uf-focus-lab/DuoController/board/specs.md

# FoveaCam Duo Driver (FoveaCamDuo-PCB): board specification, V0.1

State 2026-10-07, v0.1.2 (frozen 2026-10-07, tag v0.1.2). Generated by `board/layout.py` from `netlist.py`, `placement.py`,
`routes.py`, `silk_front.py`, `silk_back.py` and `lib/rules.py`. V0.0 is the
hand-drawn board of git 289fb6c. Requirements and the dated decision log are in the
root `specs.md`; this file holds the board's numbers. Unknowns are marked TODO.

## 1. Purpose

A Teensy 4.0 carrier that drives two Mirrorcle MEMS drivers (digital input,
AD5664R), one independent SPI bus each, triggers and reads three FLIR Blackfly S
cameras (four lines each), offers two UARTs and three 5 V fan outputs. No active
parts besides the Teensy; four optional capacitor footprints.

## 2. Block diagram

```
           J_UART1 (PH5)       J_PWR3 (PH2 fan)       J_UART2 (PH5)
           5 3 G RX1 TX1         +5V GND               5 3 G RX2 TX2
                 \                   |                    /
 J_PWR1 (PH2 fan)  J_SPI1 (DRV1) == bus 1 ==  U1 Teensy 4.0 (back) == bus 2 == J_SPI2 (DRV2)  J_PWR2 (PH2 fan)
                     EN, FCLK shared by both ports
                 /                   |                    \
           J_CAM1 (PH6)        J_CAM0 (PH6)          J_CAM2 (PH6)
           L3 IN L2 OUT GND    L3 IN L2 OUT GND      L3 IN L2 OUT GND
```

Power: +5V is the Teensy's VIN (USB VBUS through the Teensy's VIN-VUSB trace);
+3V3 is its 3V3 pin. The 2-pin sockets are fan OUTPUTS (section 5).

## 3. Teensy 4.0 pin map and the SPI buses (`board/pins.h` is generated from this)

Owner 2026-10-07: "You have permission to reorder pins if it helps with routing".
Old (V0.0) -> new (V0.1), with the reason for every move:

| Pin | V0.0 | V0.1 | Reason |
|---|---|---|---|
| 0 / 1 | RX1 / TX1 | RX1 / TX1 | Serial1 (fixed pair), straight to J_UART1 |
| 2 | GPIO header | CS1 | west-most DRV1 lane = J_SPI1 pin 7 order |
| 3 | GPIO header | SCLK1 | FlexIO1 D05; SCLK1 / MOSI1 one FlexIO module |
| 4 | GPIO header | MOSI1 | FlexIO1 D06 |
| 5 | GPIO header | CAM2_L3 | the 12th camera line; south row has 11 GPIOs; runs south of the bus lanes, round the Teensy's east end |
| 6 | GPIO header | MEMS_EN | GPIO_B0_10: 100 k pull-down during reset, keeper after it (i.MX RT1060 data sheet Rev. 4, Table 83, PDF p95; boot pins p85), so EN stays low until firmware drives it; west-most DRV2 lane |
| 7 / 8 | RX2 / TX2 | RX2 / TX2 | Serial2 (fixed pair) |
| 9 | CS1 | CS2 | DRV2 lane order (pin 7 of J_SPI2) |
| 10 | CS2 | FCLK | PWM pin; shared; its DRV1 branch runs along the north band and down the pin-row gap between pins 2 and 3 |
| 11 | MOSI (shared) | MOSI2 | FlexIO2 D02; straight up into the north wrap |
| 12 | NC (MISO) | SCLK2 | FlexIO2 D01; inner north wrap |
| 13 | SCLK (shared) | CAM2_IN | camera order on the south row (13 also drives the LED: it lights with the camera 2 trigger) |
| 14 | FCLK | CAM2_L2 | camera order |
| 15 | MEMS_EN | CAM2_OUT | camera order (strobe input) |
| 16 | NC | CAM0_L3 | camera order |
| 17 | NC | CAM0_IN | camera order |
| 18 | CAM2_IN | CAM0_L2 | camera order |
| 19 | CAM2_OUT | CAM0_OUT | camera order |
| 20 | CAM0_IN | CAM1_L3 | camera order |
| 21 | CAM0_OUT | CAM1_IN | camera order |
| 22 | CAM1_IN | CAM1_L2 | camera order |
| 23 | CAM1_OUT | CAM1_OUT | camera order |
| 24, 25 + G, 26 | 3V3, GND, VIN | same | rails |

Peripheral sources: Teensyduino 1.159 `FlexIO_t4.cpp` (Teensy 4.0 section:
flex1_hardware pins 2, 3, 4, 5 = FlexIO1 D04, D05, D06, D08; flex2_hardware pins 6-13
= FlexIO2 D10, D17, D16, D11, D00, D02, D01, D03), `core_pins.h` (pin 6 =
GPIO_B0_10, pin 2 = GPIO_EMC_04). LPSPI4 (11/12/13) is not used: pin 13 is on the
other row. Every edge GPIO is used, so MEMS_EN stays shared; an enable per driver is
wanted when a later revision frees a GPIO (owner 2026-10-07).

Routing (all checked on every build):

- Each bus's CS / SCLK / MOSI run on F.Cu only, over the unbroken B.Cu ground plane,
  with no crossing and no plane slot under them. DRV1: lanes under the Teensy
  (CS1 -2.54, FCLK 0, SCLK1 2.54, MOSI1 4.6 mm), funnel to J_SPI1, SCLK1 / MOSI1 wrap
  round its south end. DRV2: SCLK2 / MOSI2 straight up from pins 12 / 11 into the
  north band and round the north end of J_SPI2; FCLK / CS2 / MEMS_EN in lanes under
  the Teensy and up risers.
- Shared lines: the J_SPI pin order (FCLK between SYN and SCK, EN north of SYN on
  J_SPI1 but south of it on J_SPI2, the port rotated 180 degrees) forces MEMS_EN to
  cross FCLK once; MEMS_EN (static) takes that crossing on B.Cu. FCLK's north band
  passes over three short B.Cu jumps (MEMS_EN, RX2, TX2), flanked by stitching vias.
  MEMS_EN reaches J_SPI1 from the north and jumps under RX1 / TX1 on B.Cu.
- Lengths: CS1 24.2, SCLK1 38.7, MOSI1 48.4, CS2 38.3, SCLK2 18.6, MOSI2 26.6 mm;
  FCLK tree 86.6, MEMS_EN tree 85.3 mm.
- Spacing: SCLK1 / MOSI1 run 14.1 mm side by side at >= 1.1 mm (edge gap 0.85 mm,
  3.3 W); SCLK2 / MOSI2 14.6 mm at 1.05 mm (3.1 W; V0.1 draft: 12.3 mm at 0.8 mm,
  cross-check 2026-10-07). FCLK beside SCLK1 11.4 mm at 1.27 mm (the descent between
  Teensy pins 2 and 3), beside SCLK2 5.4 mm at 1.15 mm, with GND pour between.
- Track width 0.254 mm on 1.51 mm FR-4 over the B plane: microstrip about 130 ohm
  without the pour, about 100 ohm with the coplanar GND pour 0.2 mm away (estimates;
  no stackup in the board file); delay about 5.8 ps/mm (eps_eff about 3.0).
- Crosstalk on the board, worst case FCLK -> SCLK1 (11.4 mm at 1.27 mm): backward
  coefficient about 0.15 x (2 x 11.4 mm x 5.8 ps/mm) / t_r, so about 1 % of 3.3 V
  (30 mV) at a 2 ns edge: far below the 0.4 V input low limit (Mirrorcle p14). The
  ribbon cable dominates: in the 2x5 IDC cable SCK (pin 8) lies next to SYN (7) and
  FCLK_X (9) for 152 mm with one ground (pin 4); Mirrorcle p10 warns of crosstalk from
  fast FCLK / SPI edges and asks for reduced slew rates.

Timing (SCLK at f, 24-bit frame; board + cable delay about 0.2 ns + 0.8 ns one way):

| SCLK | half period | board SCLK/MOSI skew | frame (24 bits) | 4 channels |
|---|---|---|---|---|
| 1 MHz | 500 ns | < 0.06 ns | 24 us | 96 us |
| 5 MHz | 100 ns | < 0.06 ns | 4.8 us | 19.2 us |
| 10 MHz (recommended maximum until measured) | 50 ns | < 0.06 ns | 2.4 us | 9.6 us |
| 20 MHz | 25 ns | < 0.06 ns | 1.2 us | 4.8 us |

The AD5664R limits (maximum SCLK, SYNC and data set-up / hold) are TODO: the ADI
data sheet could not be fetched (site blocked from this machine). Mirrorcle: data
taken on the falling SCLK edge (p26), 24-bit words (p42).

Freeze analysis ("it randomly enters undeterministic state and froze itself"):

- Board (V0.0): one SCLK / MOSI branched to two connectors and two 6 inch cables
  with no termination and the Teensy's strongest drive: reflections from the open
  branch can double-clock the AD5664R; a corrupted 24-bit word can set a channel to
  power-down, switch the reference off or load a wrong code, and the DAC stays there
  until re-initialised. V0.1: one point-to-point bus per DAC, unbroken plane, GND pin
  of each port tied to the plane, stitching along every lane.
- Board / power: the drivers need VDD 4.85-5.2 V (p14) and have supply monitoring
  with auto-shutdown (p3); USB allows 4.75 V at the port, less after the cable and
  the Teensy. A dip (driver start-up pulses of 100 mA, fans) can shut a driver down,
  which looks like a freeze. Measure VDD at J_SPI pin 3 under load (open item).
- Firmware: no FCLK means fixed outputs (p50); CS asserted before the SPI settings
  and broadcast writes on the shared bus (V0.0 code); EN raised before the DAC init
  and FCLK (p27 order); the DAC not re-initialised per power-up (p26). Fixes in
  `board/pins.h` firmware notes and section 6.

## 4. Connectors

| Ref | Part | Side | Mating face | Pin 1 |
|---|---|---|---|---|
| J_SPI1 / J_SPI2 | CNC Tech 3220-10-0200-00, 2x5 1.27 mm right angle | W / E | 1.00 mm beyond the outline (FACE_BOX 5.90, drawing 2020) | Mirrorcle p10 order |
| J_PWR1 / J_PWR2 | JST S2B-PH-K, side entry | W / E | 1.00 mm (face 6.25 mm from the pin row, ePH.pdf, as S6B-PH-K) | +5V; J_PWR1 pin 1 south, J_PWR2 pin 1 north |
| J_CAM0..2 | JST S6B-PH-K, side entry | S | 1.00 mm (FACE_PH_S6B 6.25) | Line3 |
| J_UART1 / J_UART2 | JST B5B-PH-K, top entry | - | courtyard 2.19 mm inside the north edge | +5V |
| J_PWR3 | JST B2B-PH-K, top entry | - | courtyard 2.19 mm inside; centred in the UART row | +5V (west) |

Walls: J_SPI to J_PWR housing 6.06 mm, J_CAM1-J_CAM0 and J_CAM0-J_CAM2 5.40 mm (>=
3.0); corner post (r 3 about (+-30, -17)) to the J_SPI housing's north end 3.54 mm
(>= 3.0). Owner 2026-10-07: "ph or xh 2.0" read as JST PH (XH has no 2.0 mm pitch);
V0.0 XH cables do not fit V0.1.

Pinouts: J_SPI 1 NC, 2 NC (not grounded: NC at the driver), 3 +5V, 4 GND, 5 MEMS_EN,
6 MOSI (SDI), 7 CS (SYN), 8 SCLK (SCK), 9 FCLK (FCLK_X), 10 FCLK (FCLK_Y) (Mirrorcle
p10). J_CAM 1 Line3, 2 Line0 opto in (CAMn_IN), 3 Line2, 4 Line1 opto out
(CAMn_OUT), 5 opto GND and 6 GND both on board GND (lead interpretation; TODO check
the FLIR GPIO diagram). J_UART 1 +5V, 2 +3V3, 3 GND, 4 RX, 5 TX. J_PWR 1 +5V, 2 GND.

Fan sockets as seen from the front (y down):

```
  west edge                                   east edge
  |  J_PWR1 (opening west)                    J_PWR2 (opening east)  |
  |   [pin 2 GND ]  y 7.25         y 7.25  [ pin 1 +5V ]            |
  |   [pin 1 +5V ]  y 9.25         y 9.25  [ pin 2 GND ]            |
                 north edge, UART row:
       J_UART1 [5V 3V3 G RX TX]   J_PWR3 [+5V GND]   J_UART2 [5V 3V3 G RX TX]
```

## 5. Power and parts

- +5V source: the Teensy's USB only (owner 2026-10-07). Fan budget: USB 2.0 500 mA
  (USB 3.x 900 mA) minus Teensy about 100 mA (TODO measure) minus two drivers 2 x
  38 mA (p14; 100 mA pulses each at start-up) leaves about 300 mA for fans (about
  700 mA on USB 3.x): about 100 mA per fan socket including start-up surge on USB 2.0.
  The Teensy's VIN and VUSB are joined by a cuttable trace; do not feed power into
  the fan sockets.
- Optional capacitors (VARIANT=caps; DNP by default), one type (owner 2026-10-07):

| Ref | Value / part | Position (mm, back) | Feeds |
|---|---|---|---|
| C1 | 22 uF 25 V X7R 1210, TDK C3225X7R1E226M250AB (Digi-Key 445-C3225X7R1E226M250ABCT-ND; Murata GRM32ER71E226KE15L failed the stock rule 2026-10-07) | (-6.75, -15.5), between J_UART1 and J_PWR3 | J_PWR3 |
| C2 | same | (6.75, -15.5), between J_PWR3 and J_UART2 | north run junction |
| C3 | same | (-27.75, 2.4), between J_SPI1 and J_PWR1 | J_PWR1, J_SPI1 |
| C4 | same | (27.75, 2.4), between J_SPI2 and J_PWR2 | J_PWR2, J_SPI2 |

  Rationale: fans are noisy loads on the rail the drivers use; a 22 uF MLCC next to
  each fan output takes the start-up surge and commutation noise. One type is enough:
  a 1210 MLCC has about 1 nH ESL, so its impedance stays below 0.1 ohm from about
  70 kHz to about 15 MHz; a 100 nF part would only help above about 20 MHz, where the
  track inductance to the fan dominates anyway. DC bias at 5 V leaves roughly
  12-16 uF per part (TODO: read TDK's DC-bias curve). All four exceed the USB 2.0 inrush
  limit of 10 uF (USB 2.0 7.2.4.1), so they stay unfitted unless fan noise needs them.
  Mirrorcle recommends >= 100 uF at VDD in OEM use (p14): that belongs on the driver
  side. Mirror pairs about x = 0, clear of silk, >= pad + 4 mm from every screw pad,
  >= 1.2 mm from the outline (asserted).

## 6. Firmware notes (also in `board/pins.h`)

- Pads (IOMUXC SW_PAD_CTL): SCLKn / MOSIn / CSn DSE 1-3 (150-50 ohm, source
  termination for the cable), SRE 0 (slow), SPEED 0; FCLK DSE 1, SRE 0 (Mirrorcle p10;
  i.MX RT1060 reference manual, SW_PAD_CTL fields).
- AD5664R: 24-bit frames, data on the falling SCLK edge (SPI mode 1 or 2), SYNC low
  for the whole frame; init per power-up 0x280001, 0x380001, 0x20000F, 0x300000 (p26);
  check Vref 1.25 V when debugging (p26).
- Order (p27): DAC init, Vbias on all channels, FCLK running (60 x the cut-off,
  3 kHz-3 MHz, p14 / p16), then MEMS_EN high; shut down in reverse (p31).
- MEMS_EN (pin 6) LOW first thing in setup(). Line3 pins (5, 16, 20) INPUT from boot;
  drive only after the camera's Line3 is set as an input.

## 7. Silkscreen

- Side cue (owner 2026-10-07: "Do not use text to hint sides, use visual cues
  instead"). Visual language: a corner bracket (two 1.0 mm legs, 0.15 mm stroke,
  0.45 mm outside the housing) means "a housing sits here, on this face". Every
  connector housing is framed by brackets on the back only, at each body corner that
  falls on the board, clears other parts, keeps 0.15 mm from pads and vias; a corner
  left out also drops its mirror image, so the marks stay symmetric. The front has no
  brackets. The Teensy, which may go on either face, is marked by a USB icon at its
  USB end on both faces. Removed: the V0.1-draft legends "solder side · parts on the
  back" (front) and "parts side" (back). Variants: SIDE_MARKS=brackets (chosen) or
  icon; renders `build/silk-brackets-*.png`, `build/silk-icon-*.png`.
- Front: connector names, DRV1 / DRV2 (move with the ports), 5V by the fan sockets,
  pin labels (knockout = power: 5 = +5V, 3 = +3V3, G = GND), camera pin numbers.
- Knockout labels (v0.1.1, fab review F6): drawn as filled silk polygons, the glyph
  box grown by KNOCKOUT_MARGIN 0.2 mm with the glyphs cut out (lib/silk.py), so the
  ink round the letters is >= 0.2 mm; KiCad's own knockout leaves max(stroke / 2,
  height / 9) = 0.133 mm, under JLCPCB's 0.15 mm silk minimum. check_dfm `knockout`
  checks the margin (v0.1.0: 20 labels at 0.133 mm).
- UART labels "5 3 G T R" on both faces, centred on the pins, just south of the PH
  housings (owner 2026-10-07); "T" over pin 4 (the RX net) and "R" over pin 5 (the TX
  net) name the cable side's signal. Do not swap them. The centre socket: "5 G".
- Name block unchanged from V0.0 (exempt from the silk-under-body rule).
- Version stamp "V${REVISION} | ${GIT_SHORT}": one centre-justified Roboto Slab bold
  text (1.4 mm), both faces, centred at (0, 10.0), so KiCad centres the whole block
  whatever the variables expand to. Candidates rendered in
  `build/version-font-candidates.png`: Roboto Slab bold (chosen: same family as the
  name block, already vendored and installed by CI, thinnest stroke 0.18 mm >= the
  0.15 mm silk minimum), Roboto Mono bold and Roboto Condensed bold (both thinner,
  0.16 mm, and a second family on the board). Regular weights measure 0.15-0.18 mm,
  too close to the minimum. `build/version-stamp-variants.png`: REVISION 0.1 / 10.12
  x GIT_SHORT DEV / 289FB6C / 289FB6C+, both faces. Inked box >= 1.0 mm from the
  camera pin numbers (asserted); no via or pad under the longest stamp (asserted,
  VERSION_MAX_HALF_W 9.8 mm). TrueType texts are not measured by check_dfm (warning,
  as for the name block); KiCad's text_thickness warning stays on the copyright line
  only.

## 8. Design rules (`lib/rules.py`; profile "both" default)

Fab profiles (root specs.md 6): `both` (default) is the stricter of `jlcpcb` and
`advancedpcb` for every key, plus the owner's floors (OWNER7: copper space >= 0.008 in,
holes >= 0.020 in); `oshpark` and `original` also exist. Limits (check_dfm,
`.kicad_dru`, project rules) and the board as built:

| Key | both | jlcpcb | advancedpcb | oshpark | Board (v0.1.1) |
|---|---|---|---|---|---|
| Track | 0.127 | 0.10 | 0.127 | 0.1524 | 0.254 |
| Copper space | 0.2032 (owner) | 0.10 | 0.127 | 0.1524 | 0.205 (pour), 0.21 (J_SPI pins) |
| Smallest hole | 0.508 (owner) | 0.15 | 0.254 | 0.254 | 0.55 (vias) |
| Via ring | 0.127 | 0.05 | 0.127 | 0.127 | 0.2 |
| Plated pad ring | 0.18 | 0.18 | 0.1778 | 0.127 | 0.18 (U1, J_SPI) |
| Drill to copper | 0.254 | 0.2 | 0.254 | 0.127 | 0.39 |
| Hole to hole | 0.305 | 0.25 | 0.305 | 0.25 | 0.57 |
| Copper to edge (every profile) | 0.4 | 0.4 | 0.4 | 0.4 | 0.401 pour, 0.446 track, 0.5 screw pads |
| Mask clearance per side | 0.0762 | 0 (1:1) | 0.0762 | 0.0508 | 0.0762 |
| Mask web | 0.13 | 0.13 | 0.1016 | 0.1016 | 0.648 (J_SPI rows gang-relieved) |
| Knockout ink margin (owner key) | 0.2 | 0.2 | 0.2 | 0.2 | 0.2 |

Stackup in the board file (lib/stackup.py, from the profile): F.Cu 0.035 / FR4 core
1.51 (er 4.5) / B.Cu 0.035 = 1.6 mm; white silk; ENIG and black mask (`both`,
`jlcpcb`), lead-free HASL and green mask (`advancedpcb`, standard spec; owner "Use
standard spec"; `rules.ADVANCEDPCB_SPEC` switches to black / ENIG), ENIG and purple
(`oshpark`). The title block revision is VERSION (0.1.1).

Netclass: clearance 0.15, tracks 0.254 (signal) / 0.508 (power) / 0.8 (north +5V
run), vias 0.95 / 0.55 (0.8 / 0.4 until the owner's 0.020 in hole floor; ring 0.2).
Owner rules (owner 2026-10-07, `.kicad_dru` of every profile,
asserted in layout.py, checked by check_dfm.py), relaxed in v0.1.1 (owner "relax DRC
a bit as long as it's still comfortably above major fab specs": each >= 2 x 0.1524,
the stricter fab clearance; nothing rerouted to use the slack):

- THT pad to other-net track / via >= 0.4 mm (0.5 in v0.1.0); to +5V / +3V3 >= 0.5 mm
  (0.6). Exceptions: none.
- +5V / +3V3 track to other-net track >= 0.4 mm edge to edge (0.5; GND exempt).
- No necked track: one width per connection; exceptions: none. The J_SPI pin-3 feeds
  are 0.254 mm end to end (a 0.508 mm track could not keep the power THT clearance
  from pins 1 / 5 at 1.27 mm pitch; 38 mA).
- Teensy pads 1.36 x 2.0 mm ovals on the unchanged 1.0 mm drill (owner 2026-10-07,
  "Oval is ok if it prevents necks like this"; 1.778 mm round in V0.0, 1.27 wide in
  v0.1.0; 1.36 since v0.1.1, owner "Go for (b)", fab review O3): ring 0.18 mm across
  the row (JLCPCB 2-layer 1 oz minimum; 0.135 before), 0.5 mm along the pin; a
  0.254 mm track between two pads keeps 0.463 mm to each (>= 0.4).
- J_SPI pads 1.06 mm round on a 0.68 mm drill (CNC Tech drawing 0.70 +/-0.05; tightened
  from 0.70 by the owner 2026-10-07, V0.0's 0.762 felt loose; the Advanced order
  requests +/-0.003 in on these holes) (1.016 in v0.1.0, 1.07 earlier in v0.1.1):
  ring 0.19 mm (0.18 at the 0.70 drill, JLCPCB's PTH minimum), and
  0.21 mm copper between pins at 1.27 mm pitch (>= the owner's 0.2032; owner
  2026-10-07 "Outer Min Space 0.008"). The ring sits at the minimum by design: on a
  1.27 mm grid with a 0.70 drill the pad can be at most 1.0668 mm (ring 0.183, space
  0.2032 exactly); a non-round pad does not help, since every pin has neighbours on
  both axes. Solder mask: one gang opening per face over the ten pads (pad field +
  0.0812 mm; footprint attribute allow_soldermask_bridges), since no web >= 0.1016 mm
  fits in a 0.21 mm gap beside a 0.0762 mm clearance; the opening holds only the
  pads and their own tracks' first 0.08 mm, no pour (the pour keeps 0.4 mm from the
  pads, the opening's corners are 0.33 mm from them).
- GND pour: 0.205 mm to tracks and vias (0.6 in v0.0, 0.2 until the owner's 0.008 in
  floor), 0.4 mm to pads, 0.25 mm minimum width, thermals 0.4 / 0.4, islands removed;
  23 stitching vias tie every strip to the plane (v0.1.1; 12 pour pieces on F.Cu and 4
  on B.Cu, as with 0.2 / 0.8 mm vias: the via at (17.78, -9.525) came within 0.15 mm
  of a UART2 label at 0.95 mm, no grid point within 2.5 mm fits, and its strip stays
  tied without it).
- Owner floors (OWNER7, owner 2026-10-07 for the Advanced PCB quote form: "I meant
  Outer Min Space 0.008", also can you make smallest hole actually 0.020?"): copper
  to copper of different nets >= 0.2032 mm on both layers (KiCad DRC with the
  project's min_clearance; layout.py asserts the pour clearance and every pad-to-pad
  gap) and every finished hole >= 0.508 mm (DRC min_through_hole_diameter; layout.py
  and check_dfm `hole_min`). Measured: space 0.205 mm (8.1 mil), smallest hole
  0.55 mm. Holes: vias 0.55 x 33, 0.68 x 20 (J_SPI), 0.80 x 34 (JST PH), 1.0 x 28
  (U1), 2.7 x 4 (screw holes), all plated; 119 in all.
- JST PH drills 0.80 mm finished on all four PH footprints (S6B, B5B, S2B, B2B;
  owner 2026-10-07, v0.1.2; 0.75 before): JST ePH.pdf p1 gives the PCB hole as
  0.7 +0.1/0 and note 3 asks for a larger hole on glass-fibre boards ("When using PCB
  made of hard material composed of fiberglass cloth, please consider a larger hole
  diameter"); at the fabs' tolerances a 0.75 hole can finish at 0.67 (JLCPCB -0.08) or
  0.623 (Advanced PCB -0.127), below JST's 0.7. Pads stay 1.2 x 1.75 mm: ring
  0.20 mm (>= JLCPCB 0.18, Advanced 0.178).
- No bare channels between tracks (owner 2026-10-07 "try to fix the voids between
  the traces"): two neighbouring tracks are either 0.914 mm or more apart (0.254 +
  2 x 0.205 + 0.25: a GND strip fills between them, tied to the plane by vias or by the
  gaps between the oval Teensy pads) or packed tight. Done in v0.1.1: camera rails
  1.0 mm apart (were 0.8), the DRV2 risers 1.0 mm apart (CS2 / MEMS_EN were 0.9), the
  J_SPI2 pin-3 feed pulled to the (then) 0.6 mm THT limit, the +3V3 run north of J_SPI1 moved
  so the strip fills, the north-band vias spread so the pour reaches between them.
  check_dfm `bare_channel` reports bare board between tracks wider than 2 x 0.205 +
  0.05 mm, `pour_void` unfilled areas over 2 mm2. Before v0.1.1: 14 channels on F.Cu
  (largest 8.5 mm2 west of J_SPI2's pads, 5.3 mm2 between the camera rails), 1 on B.Cu,
  1 void. After: 4 small pockets on F.Cu, all under the UART housings (1.75 mm2 at
  (19.16, -13.10) between the RX2 / TX2 drops of J_UART2; 0.19 mm2 at (-19.41,
  -13.32); 0.20 mm2 at (15.51, -13.43) and (17.51, -13.43) below the pad gaps): there
  the 0.4 mm pad clearance, the THT rule and the lanes under the pads leave no room
  for a strip or a via. (5 with the v0.1.0 clearances; the 0.4 mm THT rule let the
  RX2 / TX2 lanes move to 0.4 mm from the J_UART pads, which removed one; not rerouted
  further.) No voids.
- Via grid (owner 2026-10-07 "snap drills to a grid"): every via centre on a 0.635 mm
  grid (2.54 / 4) about the board centre, the frame of the Teensy and the connectors;
  stitching vias prefer 1.27 mm grid points, so they line up in rows and columns.
  Asserted in layout.py (1 um, rules.VIA_GRID_EXCEPTIONS empty). The signal vias moved
  with it: the FCLK north band to y -9.525, the MEMS_EN band and vias to y -10.795, the
  RX2 / TX2 vias to (5.08 / 6.985, -11.43), the +5V junctions to (-24.765, -11.43),
  (-1.27, -17.78) and (12.065, -17.78).
- Hole to hole: vias >= 0.25, any pair with a pad hole >= 0.45; via copper >= 0.2 mm
  from every pad; silk >= 0.15 mm from pads and vias (J-CAP, owner).
- Sidewall band EDGE_SAFE 1.2 mm: closest courtyards C1 / C2 1.98 mm, J_UART / J_PWR3
  2.19 mm, C3 / C4 2.73 mm; all silk and pads inside. In the band by design: the screw
  pads (check_dfm waiver `edge_safe` MH), the +3V3 back run along the north edge
  (0.446 mm to the outline) and the pour (copper under mask; info).
- Screw holes MH1..4 (v0.1.1, owner "Do screw holes as recommended", fab review F2
  option A): footprint `FoveaCamDuo:MountingHole_2.7mm_M2.5_Pad5.0`, plated 2.7 mm
  drill, 5.0 mm round pad on both faces, no net, board-only (not in the BOM or
  position files), in the PTH drill file; the r 3 corner arcs about the hole centres
  leave 0.5 mm of board round the pad (>= 0.4 asserted). Replaces V0.0 / v0.1.0's
  routed 2.5 mm cut-outs under copper rings (0 mm copper to the cut). No NPTH holes
  remain, so the fab set has no NPTH file. Keep-outs: optional capacitors >= pad r
  2.5 + 4 mm from the hole centres (SCREW_KEEPOUT); other pads clear of the screw
  pads (asserted).

## 9. Open items

1. AD5664R timing (section 3) from the ADI data sheet.
2. VDD at the drivers under load on USB power (>= 4.85 V, Mirrorcle p14).
3. FLIR Line3 doubles as VAUX: a camera configured to output VAUX would put 8-24 V on
   a Teensy pin (3.6 V abs. max). No protection on the board (zero added parts).
4. A 2-pin PH fan plug fits shifted into a 5-pin PH UART header.
5. ~~JST order suffixes; Teensy socket strips~~: resolved 2026-10-07 (`docs/bom-digikey.md`); Teensy stand-off: PCB 11.0 mm below the board on 8.50 mm Sullins strips.
6. The Teensy has no 3D model (renders show bare pads).
7. Capacitor DC-bias value (TDK curve, not machine-readable; read by hand).
8. Fan selection and current.
