uf-focus-lab/DuoController/board/bringup.md

# FoveaCam Duo Driver: bring-up checklist

GENERATED by tools/gen_bringup.py from board/netlist.py; do not edit.

Bare board first (no Teensy), then with the Teensy fitted.  Tick each row.

## 1. Rail isolation (bare board, multimeter on resistance)

| Between | Expect |
|---|---|
| +5V and +3V3 | open (no short) |
| +5V and GND | open (no short) |
| +3V3 and GND | open (no short) |

Probe points: +5V = J_UART1 pin 1, +3V3 = J_UART1 pin 2, GND = J_UART1 pin 3.

## 2. Continuity, connector pin to Teensy pin

| Connector | Pin | Net | Teensy pin | OK |
|---|---|---|---|---|
| J_CAM0 | 1 | CAM0_L3 | 16 | [ ] |
| J_CAM0 | 2 | CAM0_IN | 17 | [ ] |
| J_CAM0 | 3 | CAM0_L2 | 18 | [ ] |
| J_CAM0 | 4 | CAM0_OUT | 19 | [ ] |
| J_CAM0 | 5 | GND | GND | [ ] |
| J_CAM0 | 6 | GND | GND | [ ] |
| J_CAM1 | 1 | CAM1_L3 | 20 | [ ] |
| J_CAM1 | 2 | CAM1_IN | 21 | [ ] |
| J_CAM1 | 3 | CAM1_L2 | 22 | [ ] |
| J_CAM1 | 4 | CAM1_OUT | 23 | [ ] |
| J_CAM1 | 5 | GND | GND | [ ] |
| J_CAM1 | 6 | GND | GND | [ ] |
| J_CAM2 | 1 | CAM2_L3 | 5 | [ ] |
| J_CAM2 | 2 | CAM2_IN | 13 | [ ] |
| J_CAM2 | 3 | CAM2_L2 | 14 | [ ] |
| J_CAM2 | 4 | CAM2_OUT | 15 | [ ] |
| J_CAM2 | 5 | GND | GND | [ ] |
| J_CAM2 | 6 | GND | GND | [ ] |
| J_PWR1 | 1 | +5V | VIN | [ ] |
| J_PWR1 | 2 | GND | GND | [ ] |
| J_PWR2 | 1 | +5V | VIN | [ ] |
| J_PWR2 | 2 | GND | GND | [ ] |
| J_PWR3 | 1 | +5V | VIN | [ ] |
| J_PWR3 | 2 | GND | GND | [ ] |
| J_SPI1 | 3 | +5V | VIN | [ ] |
| J_SPI1 | 4 | GND | GND | [ ] |
| J_SPI1 | 5 | MEMS_EN | 6 | [ ] |
| J_SPI1 | 6 | MOSI1 | 4 | [ ] |
| J_SPI1 | 7 | CS1 | 2 | [ ] |
| J_SPI1 | 8 | SCLK1 | 3 | [ ] |
| J_SPI1 | 9 | FCLK | 10 | [ ] |
| J_SPI1 | 10 | FCLK | 10 | [ ] |
| J_SPI1 | 1, 2 | not connected (check open to GND) | | [ ] |
| J_SPI2 | 3 | +5V | VIN | [ ] |
| J_SPI2 | 4 | GND | GND | [ ] |
| J_SPI2 | 5 | MEMS_EN | 6 | [ ] |
| J_SPI2 | 6 | MOSI2 | 11 | [ ] |
| J_SPI2 | 7 | CS2 | 9 | [ ] |
| J_SPI2 | 8 | SCLK2 | 12 | [ ] |
| J_SPI2 | 9 | FCLK | 10 | [ ] |
| J_SPI2 | 10 | FCLK | 10 | [ ] |
| J_SPI2 | 1, 2 | not connected (check open to GND) | | [ ] |
| J_UART1 | 1 | +5V | VIN | [ ] |
| J_UART1 | 2 | +3V3 | 3V3 | [ ] |
| J_UART1 | 3 | GND | GND | [ ] |
| J_UART1 | 4 | RX1 | 0 | [ ] |
| J_UART1 | 5 | TX1 | 1 | [ ] |
| J_UART2 | 1 | +5V | VIN | [ ] |
| J_UART2 | 2 | +3V3 | 3V3 | [ ] |
| J_UART2 | 3 | GND | GND | [ ] |
| J_UART2 | 4 | RX2 | 7 | [ ] |
| J_UART2 | 5 | TX2 | 8 | [ ] |

## 3. Power-up

1. Power: +5V comes only from the Teensy's USB through its VIN pin (VIN and VUSB bridged on the Teensy, as shipped). J_PWR1-3 are 5 V OUTPUTS for cooling fans, never feed power into them (owner 2026-10-07; budget in specs.md 4: about 100 mA per fan on USB 2.0). The optional capacitors (VARIANT=caps) exceed the USB 2.0 inrush limit of 10 uF; fit them only if fan noise needs them.
2. Flash the V0.1 firmware (pins as in board/pins.h, firmware notes at its end) into the Teensy before it goes onto this board: the V0.1 pin map differs from V0.0 on almost every pin.
3. Fit the Teensy (socket strips on the back, USB end west, at the USB icon). Repeat section 1 (+5V to GND and +3V3 to GND must not read as a short).
4. Power up from USB with no MEMS driver, camera or fan connected.
5. Measure +5V (J_UART1 pin 1, J_PWR1-3 pin 1) and +3V3 (J_UART1 pin 2) against GND (J_UART1 pin 3).
6. Check that MEMS_EN (J_SPI1 / J_SPI2 pin 5, Teensy pin 6) reads LOW from reset until the firmware enables the drivers (pin 6 is pulled down during reset and kept by its keeper; the firmware drives it LOW first, pins.h).
7. Load a sketch that toggles each output in board/pins.h and check it at the connector pins of section 2 (MEMS_EN, FCLK, CSn, SCLKn, MOSIn; CAMn_IN); with INPUT_PULLUP on CAMn_OUT and CAMn_L2, shorting the connector pin to GND must read LOW. Leave CAMn_L3 as inputs.
8. Connect one MEMS driver to J_SPI1 (DRV1), check it powers from +5V, then the second on J_SPI2 (DRV2). Bring-up order per the Mirrorcle guide p27: DAC init, Vbias, FCLK, then MEMS_EN high.
9. Connect the cameras (J_CAM0..2): FLIR GPIO cable pin n to J_CAMn pin n. Pin 1 (Line3) is wired to a Teensy pin: never configure the camera to output VAUX (8-24 V) on Line3. Connect opto GND (blue, pin 5) before any signal (FLIR warning).
