uf-focus-lab/DuoController/board/FoveaCamDuo-PCB.kicad_pcb

## KiCad design board/FoveaCamDuo-PCB.kicad_pcb (2026-10-21)

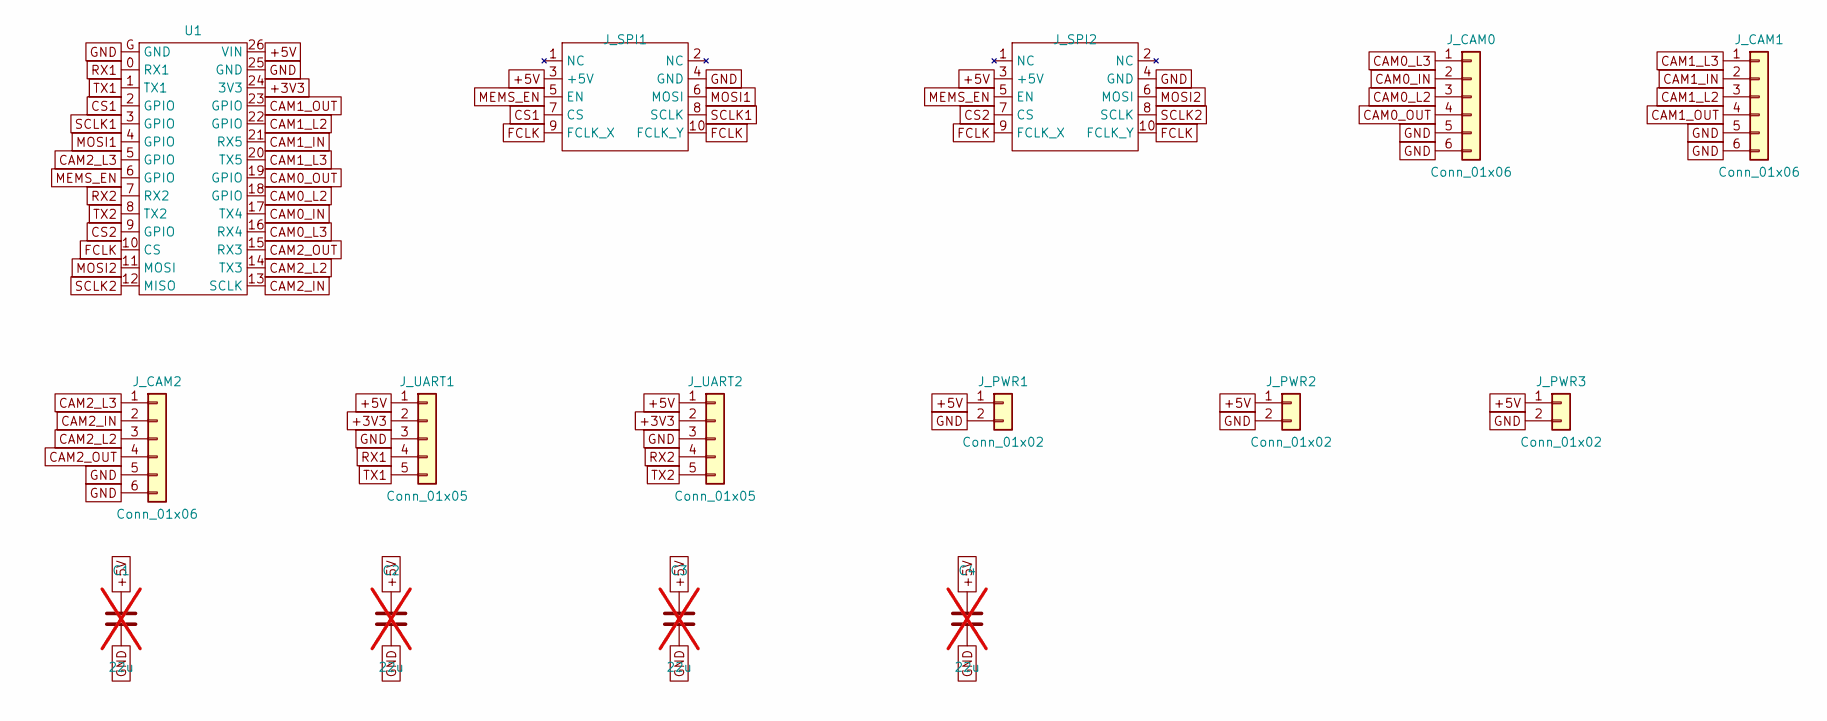
[picture p1: schematic FoveaCamDuo-PCB.kicad_sch, FoveaCam Duo Driver]

Parts:
C1, C2, C3, C4: 22u; C_1210_3225Metric_Pad1.33x2.70mm_HandSolder; MPN C3225X7R1E226M250AB; not fitted
J_CAM0, J_CAM1, J_CAM2: Conn_01x06; JST_PH_S6B-PH-K_1x06_P2.00mm_Horizontal_NoSilkScreen; MPN S6B-PH-K-S
J_PWR1, J_PWR2: Conn_01x02; JST_PH_S2B-PH-K_1x02_P2.00mm_Horizontal_NoSilkScreen; MPN S2B-PH-K-S
J_PWR3: Conn_01x02; JST_PH_B2B-PH-K_1x02_P2.00mm_Vertical_NoSilkScreen; MPN B2B-PH-K-S
J_SPI1, J_SPI2: PinHeader_1x10_P1.27mm_Horizontal_Box; MPN 3220-10-0200-00
J_UART1, J_UART2: Conn_01x05; JST_PH_B5B-PH-K_1x05_P2.00mm_Vertical_NoSilkScreen; MPN B5B-PH-K-S
U1: Teensy_4_0; MPN Teensy 4.0

Connections:
+3V3: J_UART1.2, J_UART2.2, U1.24 (3V3)
+5V: C1.1, C2.1, C3.1, C4.1, J_PWR1.1, J_PWR2.1, J_PWR3.1, J_SPI1.3 (+5V), J_SPI2.3 (+5V), J_UART1.1, J_UART2.1, U1.26 (VIN)
CAM0_IN: J_CAM0.2, U1.17 (TX4)
CAM0_L2: J_CAM0.3, U1.18 (GPIO)
CAM0_L3: J_CAM0.1, U1.16 (RX4)
CAM0_OUT: J_CAM0.4, U1.19 (GPIO)
CAM1_IN: J_CAM1.2, U1.21 (RX5)
CAM1_L2: J_CAM1.3, U1.22 (GPIO)
CAM1_L3: J_CAM1.1, U1.20 (TX5)
CAM1_OUT: J_CAM1.4, U1.23 (GPIO)
CAM2_IN: J_CAM2.2, U1.13 (SCLK)
CAM2_L2: J_CAM2.3, U1.14 (TX3)
CAM2_L3: J_CAM2.1, U1.5 (GPIO)
CAM2_OUT: J_CAM2.4, U1.15 (RX3)
CS1: J_SPI1.7 (CS), U1.2 (GPIO)
CS2: J_SPI2.7 (CS), U1.9 (GPIO)
FCLK: J_SPI1.9 (FCLK_X), J_SPI1.10 (FCLK_Y), J_SPI2.9 (FCLK_X), J_SPI2.10 (FCLK_Y), U1.10 (CS)
GND: C1.2, C2.2, C3.2, C4.2, J_CAM0.5, J_CAM0.6, J_CAM1.5, J_CAM1.6, J_CAM2.5, J_CAM2.6, J_PWR1.2, J_PWR2.2, J_PWR3.2, J_SPI1.4 (GND), J_SPI2.4 (GND), J_UART1.3, J_UART2.3, U1.25 (GND), U1.G (GND)
MEMS_EN: J_SPI1.5 (EN), J_SPI2.5 (EN), U1.6 (GPIO)
MOSI1: J_SPI1.6 (MOSI), U1.4 (GPIO)
MOSI2: J_SPI2.6 (MOSI), U1.11 (MOSI)
RX1: J_UART1.4, U1.0 (RX1)
RX2: J_UART2.4, U1.7 (RX2)
SCLK1: J_SPI1.8 (SCLK), U1.3 (GPIO)
SCLK2: J_SPI2.8 (SCLK), U1.12 (MISO)
TX1: J_UART1.5, U1.1 (TX1)
TX2: J_UART2.5, U1.8 (TX2)

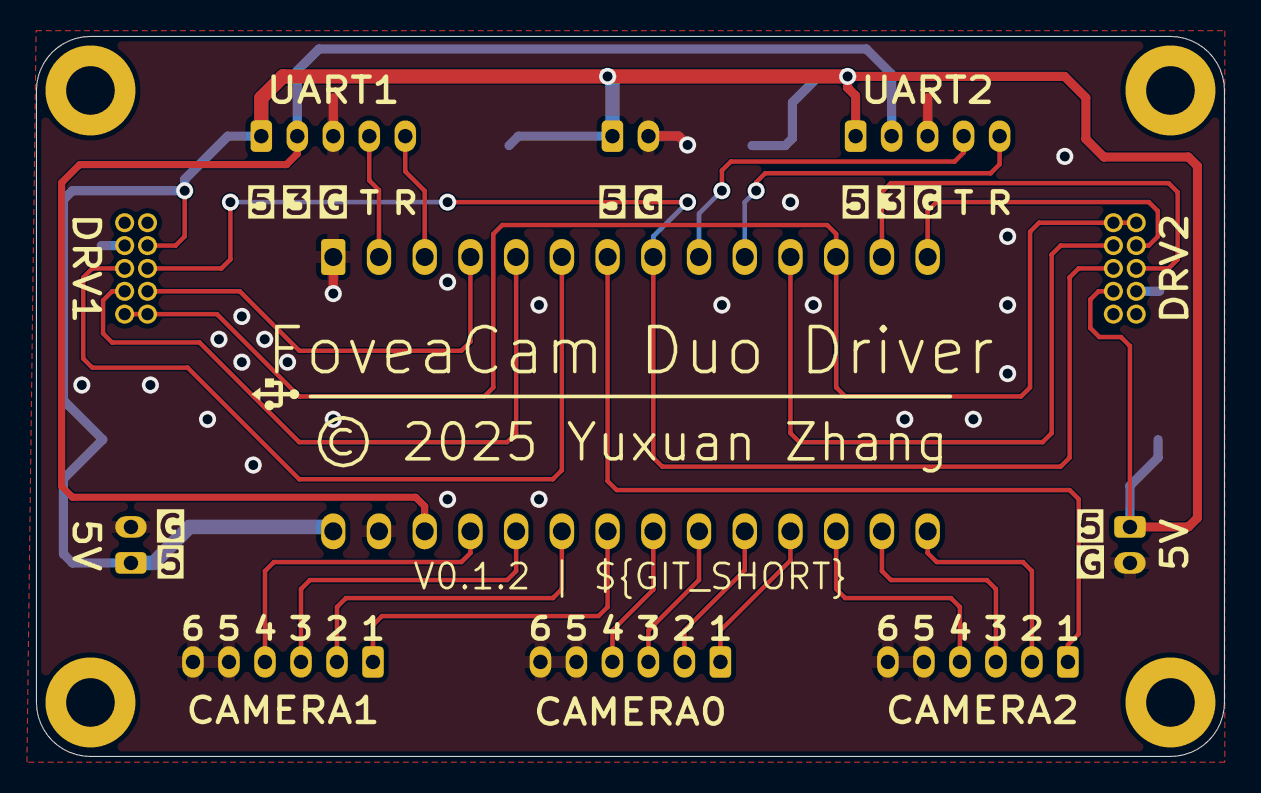
[picture p2: board FoveaCamDuo-PCB.kicad_pcb from above]

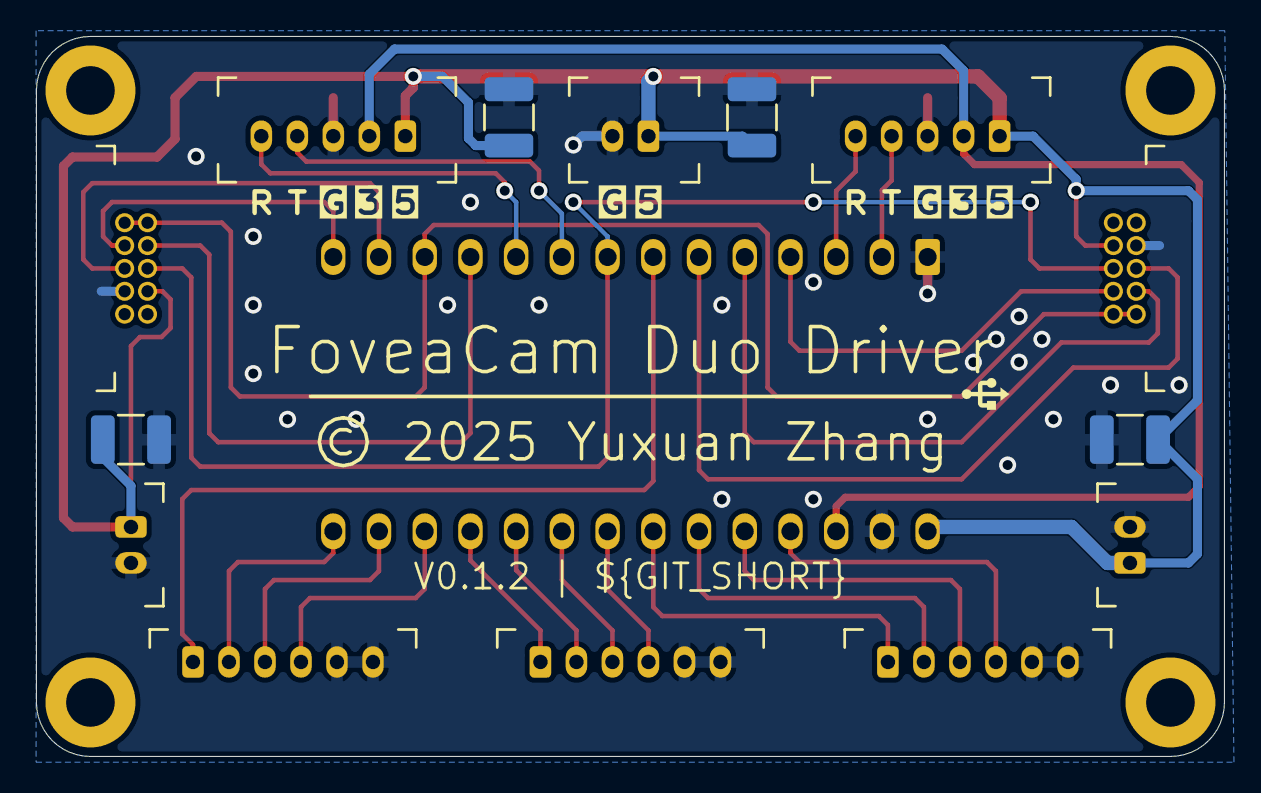
[picture p3: board FoveaCamDuo-PCB.kicad_pcb from below]

Board: 2 copper layers, 66.0 x 40.0 mm, 19 parts (15 on the bottom side), 27 nets.

Other parts of the board:
MH1, MH2, MH3, MH4: M2.5; MountingHole_2.7mm_M2.5_Pad5.0
