uf-focus-lab/DuoController/board/pins.h

/* FoveaCam Duo Driver: Teensy 4.0 pin map.
 *
 * GENERATED by tools/gen_pins.py from board/netlist.py (sha1 770d2c06a77e); do not edit.
 * Numbers are Teensy digital pin numbers (pinMode / digitalWrite).
 */
#ifndef FOVEACAM_DUO_PINS_H
#define FOVEACAM_DUO_PINS_H

#define PIN_RX1       0   /* RX1: J_UART1.4 */
#define PIN_TX1       1   /* TX1: J_UART1.5 */
#define PIN_CS1       2   /* CS1: J_SPI1.7 */
#define PIN_SCLK1     3   /* SCLK1: J_SPI1.8 */
#define PIN_MOSI1     4   /* MOSI1: J_SPI1.6 */
#define PIN_CAM2_L3   5   /* CAM2_L3: J_CAM2.1 */
#define PIN_MEMS_EN   6   /* MEMS_EN: J_SPI1.5, J_SPI2.5 */
#define PIN_RX2       7   /* RX2: J_UART2.4 */
#define PIN_TX2       8   /* TX2: J_UART2.5 */
#define PIN_CS2       9   /* CS2: J_SPI2.7 */
#define PIN_FCLK     10   /* FCLK: J_SPI1.10, J_SPI1.9, J_SPI2.10, J_SPI2.9 */
#define PIN_MOSI2    11   /* MOSI2: J_SPI2.6 */
#define PIN_SCLK2    12   /* SCLK2: J_SPI2.8 */
#define PIN_CAM2_IN  13   /* CAM2_IN: J_CAM2.2 */
#define PIN_CAM2_L2  14   /* CAM2_L2: J_CAM2.3 */
#define PIN_CAM2_OUT 15   /* CAM2_OUT: J_CAM2.4 */
#define PIN_CAM0_L3  16   /* CAM0_L3: J_CAM0.1 */
#define PIN_CAM0_IN  17   /* CAM0_IN: J_CAM0.2 */
#define PIN_CAM0_L2  18   /* CAM0_L2: J_CAM0.3 */
#define PIN_CAM0_OUT 19   /* CAM0_OUT: J_CAM0.4 */
#define PIN_CAM1_L3  20   /* CAM1_L3: J_CAM1.1 */
#define PIN_CAM1_IN  21   /* CAM1_IN: J_CAM1.2 */
#define PIN_CAM1_L2  22   /* CAM1_L2: J_CAM1.3 */
#define PIN_CAM1_OUT 23   /* CAM1_OUT: J_CAM1.4 */

/* Level read on PIN_CAMn_OUT while camera n exposes: the camera's
 * opto output (open collector) pulls the line LOW against the
 * Teensy's internal pull-up (INPUT_PULLUP); no receiver on the board. */
#define STROBE_ACTIVE_LEVEL LOW

/* Firmware notes (board/netlist.py FIRMWARE_NOTES):
 * Buses: DRV1 = FlexIO1 (SCLK1 3 = FlexIO1 D05, MOSI1 4 = D06), DRV2 =
 * FlexIO2 (SCLK2 12 = D01, MOSI2 11 = D02); CS1 / CS2 plain GPIO.  [Teensyduino
 * 1.159 FlexIO_t4.cpp flex1_hardware / flex2_hardware, Teensy 4.0 section]
 * AD5664R frame: 24 bits, data taken on the SCLK falling edge (SPI mode 1
 * or 2), SYNC low for the whole frame.  [Mirrorcle MEMS Drivers 5.x guide
 * p26, p42]  Init per power-up: 0x280001, 0x380001, 0x20000F, 0x300000 (p26).
 * Pads (IOMUXC SW_PAD_CTL): SCLKn / MOSIn / CSn DSE 1..3 (150..50 ohm),
 * SRE 0 (slow), SPEED 0; FCLK DSE 1, SRE 0.  The guide warns of crosstalk
 * from fast FCLK / SPI edges and asks for reduced slew rates (p10).
 * [i.MX RT1060 reference manual, IOMUXC SW_PAD_CTL_PAD_* fields]
 * MEMS_EN (6 = GPIO_B0_10): 100 k pull-down during reset, keeper after it
 * [i.MX RT1060 datasheet Rev. 4, Table 83, PDF p95; boot pins p85].  Drive
 * it LOW first thing in setup(); raise it only after the DAC init, Vbias on
 * all channels and FCLK running; drop it before stopping SPI or FCLK
 * [guide p27 steps 1-5, p31].  It enables both drivers (shared).
 * FCLK (10, PWM): 50 % square wave at 60 x the filter cut-off, 3 kHz..3 MHz,
 * one clock for both drivers and both axes [guide p14, p16, p41].
 * Line3 (CAMn_L3: 5, 16, 20): keep INPUT (high-Z) from boot; drive only
 * after the camera's Line3 is set as an input (Line3 is also the camera's
 * 8-24 V VAUX input; a Teensy pin is 3.6 V abs. max).
 * Strobes (CAMn_OUT: 23, 19, 15): INPUT_PULLUP, active LOW; any pin can
 * attachInterrupt.  Triggers (CAMn_IN: 21, 17, 13) are outputs; pin 13
 * also drives the Teensy LED (it lights with the camera 2 trigger).
 * No spare pin: an enable per driver is wanted (owner 2026-10-07) once a
 * GPIO is free in a later revision.
 */

#endif /* FOVEACAM_DUO_PINS_H */
